SteveMayze/ClockDisplayModule/uctrl/kicad/doc/Salea-FramingError.png

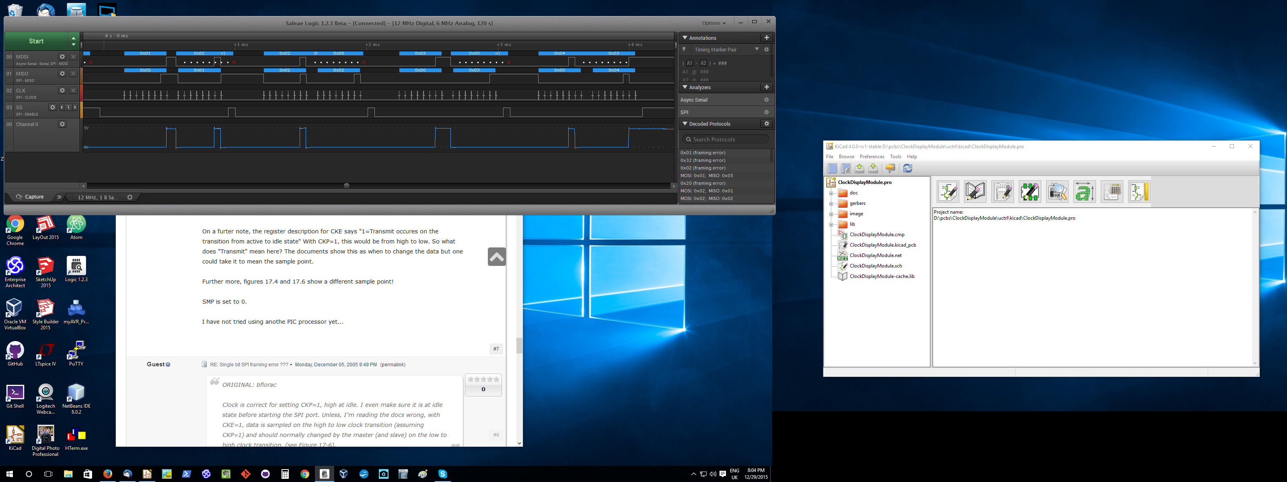
uctrl/kicad/doc/Salea-FramingError.png
