SteveMayze/ClockDisplayModule/README.md

# ClockDisplayModule
A module to provide a 4x7 Segment display digital clock face
