SteveMayze/ClockDisplayModule/uctrl/kicad/doc/my7Segement-Schematic.png

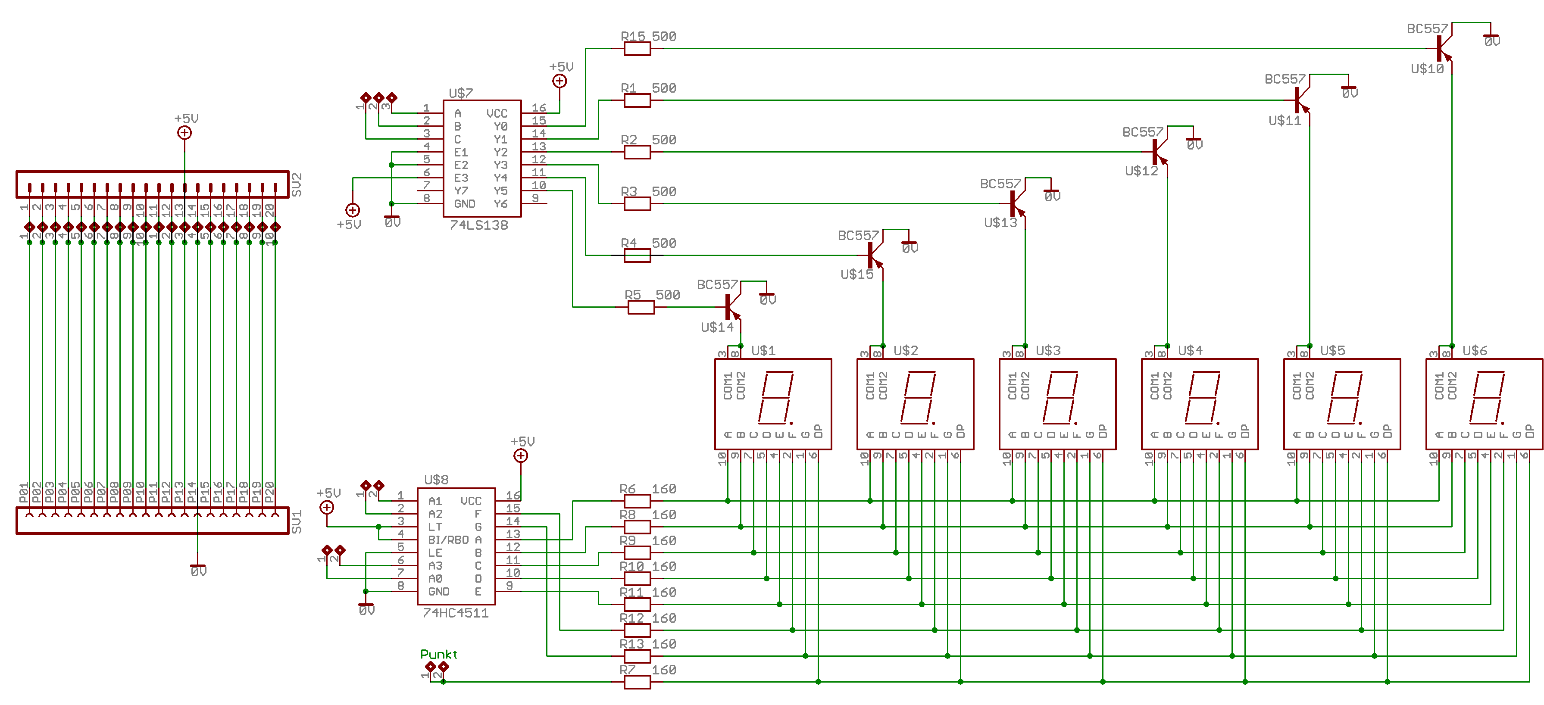
uctrl/kicad/doc/my7Segement-Schematic.png
