SteveMayze/ClockDisplayModule/uctrl/kicad/doc/Salea-FramingError-2.png

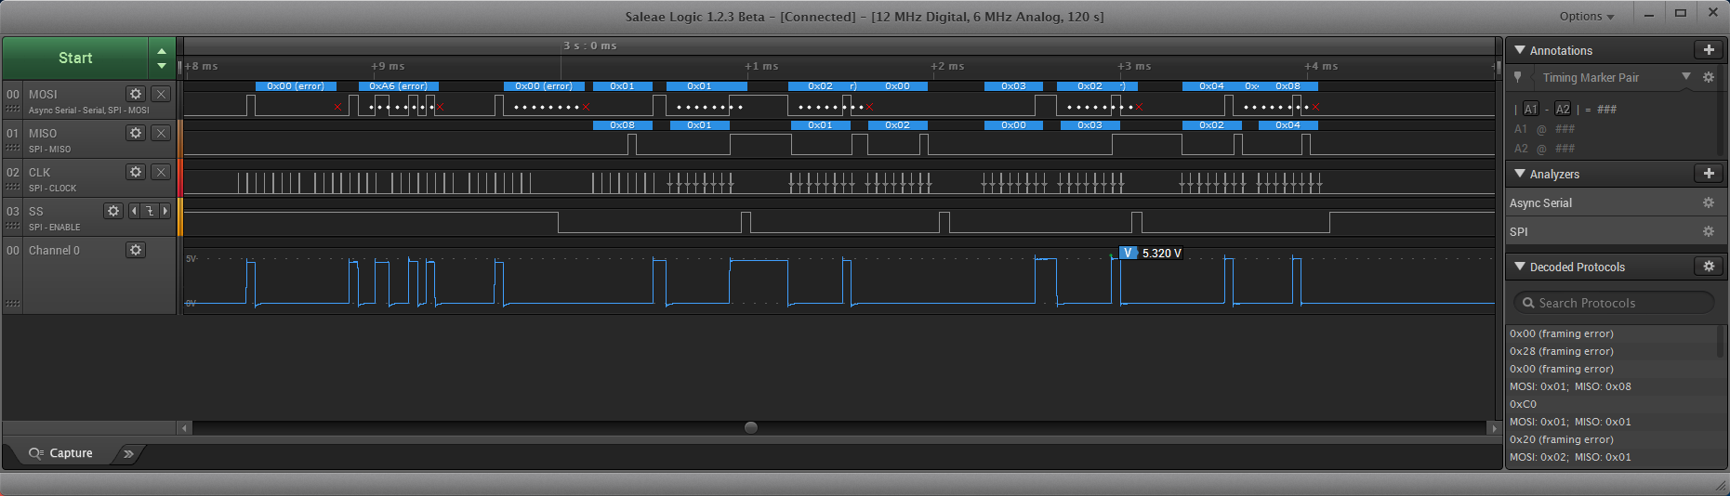
uctrl/kicad/doc/Salea-FramingError-2.png
