SteveMayze/ClockDisplayModule/smallDisplay/kicad/ClockDisplayModule.ods

 |  | Clock Display Module
Reference | Quantity | Value | Footprint | MPN | ConradPN
AFF101 AFF102 AFF103 AFF104 | 4 | NKR161B | ClockFootprints:161_163_Series | NKR161B | N/A
C101 | 1 | 10u | Capacitors_SMD:c_elec_4x5.8 | EEE-FK1C100R | 443516 - 62
C102 | 1 | 0.1u | Capacitors_SMD:C_0805_HandSoldering
D101 | 1 | Colon1 | LEDs:LED-0805 | Value | Value
D102 | 1 | Colon2 | LEDs:LED-0805 | Value | Value
D103 | 1 | Alarm | LEDs:LED-0805 | Value | Value
D104 | 1 | Auto | LEDs:LED-0805 | Value | Value
P101 | 1 | CONN_01X05 | Pin_Headers:Pin_Header_Straight_1x05
R101 | 1 | 25K | Resistors_SMD:R_0805_HandSoldering
R102 R103 R104 R105 | 4 | 0 | Resistors_SMD:R_0805_HandSoldering
U101 | 1 | MAX7221 | ClockFootprints:SOIC-24 | MAX7221 | 170137 - 62
