SteveMayze/ClockDisplayModule/(list of files, cad)

Other CAD files:
smallDisplay/firmware/blinker.obj
smallDisplay/firmware/simpleCheck.obj
