SteveMayze/ClockDisplayModule/smallDisplay/kicad/doc/CurrentUsage.ods

Digit 1 | Digit 2 | Digit 3 | Digit 4 | Colon | Segments | mA | mA/Segment | Rset
2 | 6 | 4 | 7 | 2 | 21 | 34.72 | 1.6533 | 322,580.64516
2 | 6 | 5 | 6 | 2 | 21 | 36.25 | 1.7262 | 308,965.51724
2 | 6 | 5 | 2 | 2 | 17 | 29.95 | 1.7618 | 302,726.76683
2 | 6 | 5 | 5 | 2 | 20 | 34.71 | 1.7355 | 307,308.17248
2 | 6 | 5 | 6 | 2 | 21 | 36.27 | 1.7271 | 308,795.14750
5 | 6 | 6 | 4 | 2 | 23 | 39.70 | 1.7261 | 308,984.04702
5 | 6 | 6 | 5 | 2 | 24 | 41.20 | 1.7167 | 310,679.61165
5 | 6 | 6 | 6 | 2 | 25 | 42.70 | 1.7080 | 312,256.04996
5 | 6 | 2 | 6 | 2 | 21 | 36.40 | 1.7333 | 307,692.30769
5 | 6 | 2 | 5 | 2 | 20 | 34.79 | 1.7395 | 306,601.51384
 |  |  |  |  | 60% Error from the calculated value
