SteveMayze/ClockDisplayModule/uctrl/kicad/ClockDisplayModule.kicad_pcb

## KiCad design uctrl/kicad/ClockDisplayModule.kicad_pcb (2016-01-14)

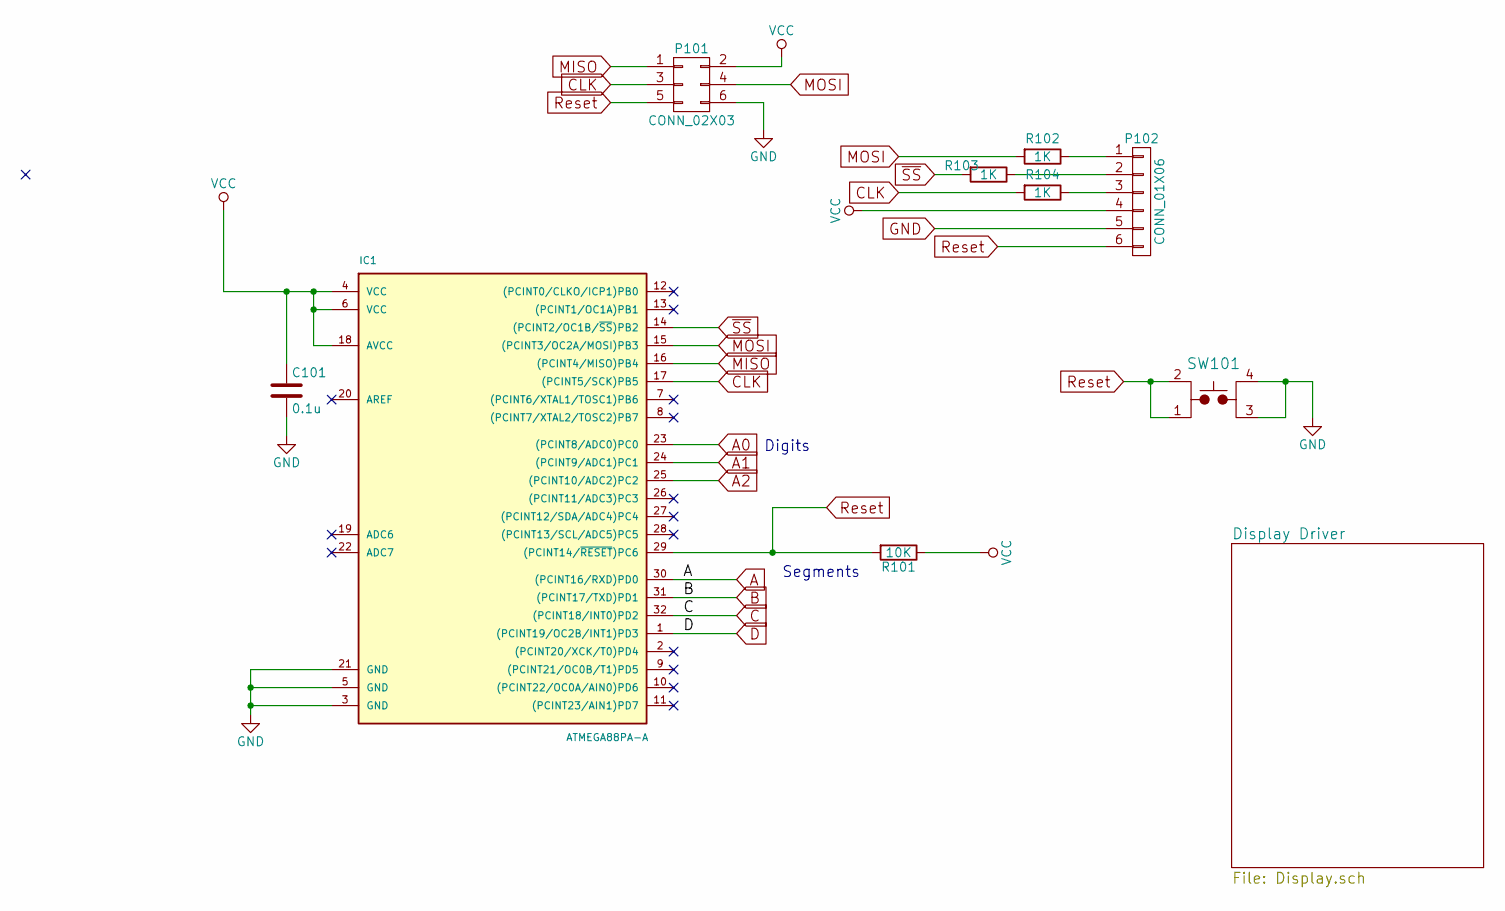
[picture p6: schematic ClockDisplayModule.sch, Clock display module]

Parts:
C101: 0.1u; C_0805
IC1: ATMEGA88PA-A; LQFP-32_7x7mm_Pitch0.8mm
P101: CONN_02X03; Pin_Header_Straight_2x03; MPN WS6G
P102: CONN_01X06; Pin_Header_Straight_1x06
R101: 10K; R_0805
R102, R103, R104: 1K; R_0805
SW101: TL3315NF160Q; PTS525SM15SMTR2LFS

Connections:
A: IC1.30 ((PCINT16/RXD)PD0); also elsewhere on the board
A0: IC1.23 ((PCINT8/ADC0)PC0); also elsewhere on the board
A1: IC1.24 ((PCINT9/ADC1)PC1); also elsewhere on the board
A2: IC1.25 ((PCINT10/ADC2)PC2); also elsewhere on the board
B: IC1.31 ((PCINT17/TXD)PD1); also elsewhere on the board
C: IC1.32 ((PCINT18/INT0)PD2); also elsewhere on the board
CLK: IC1.17 ((PCINT5/SCK)PB5), P101.3, R104.2
D: IC1.1 ((PCINT19/OC2B/INT1)PD3); also elsewhere on the board
GND: C101.2, IC1.3 (GND), IC1.5 (GND), IC1.21 (GND), P101.6, P102.5, SW101.3, SW101.4; also elsewhere on the board
MISO: IC1.16 ((PCINT4/MISO)PB4), P101.1
MOSI: IC1.15 ((PCINT3/OC2A/MOSI)PB3), P101.4, R102.2
unnamed: P102.1, R102.1
unnamed: P102.2, R103.1
unnamed: P102.3, R104.1
Reset: IC1.29 ((PCINT14/~RESET~)PC6), P101.5, P102.6, R101.2, SW101.1, SW101.2
VCC: C101.1, IC1.4 (VCC), IC1.6 (VCC), IC1.18 (AVCC), P101.2, P102.4, R101.1; also elsewhere on the board
~SS: IC1.14 ((PCINT2/OC1B/~SS~)PB2), R103.2

Notes on the sheet:
Digits
Segments

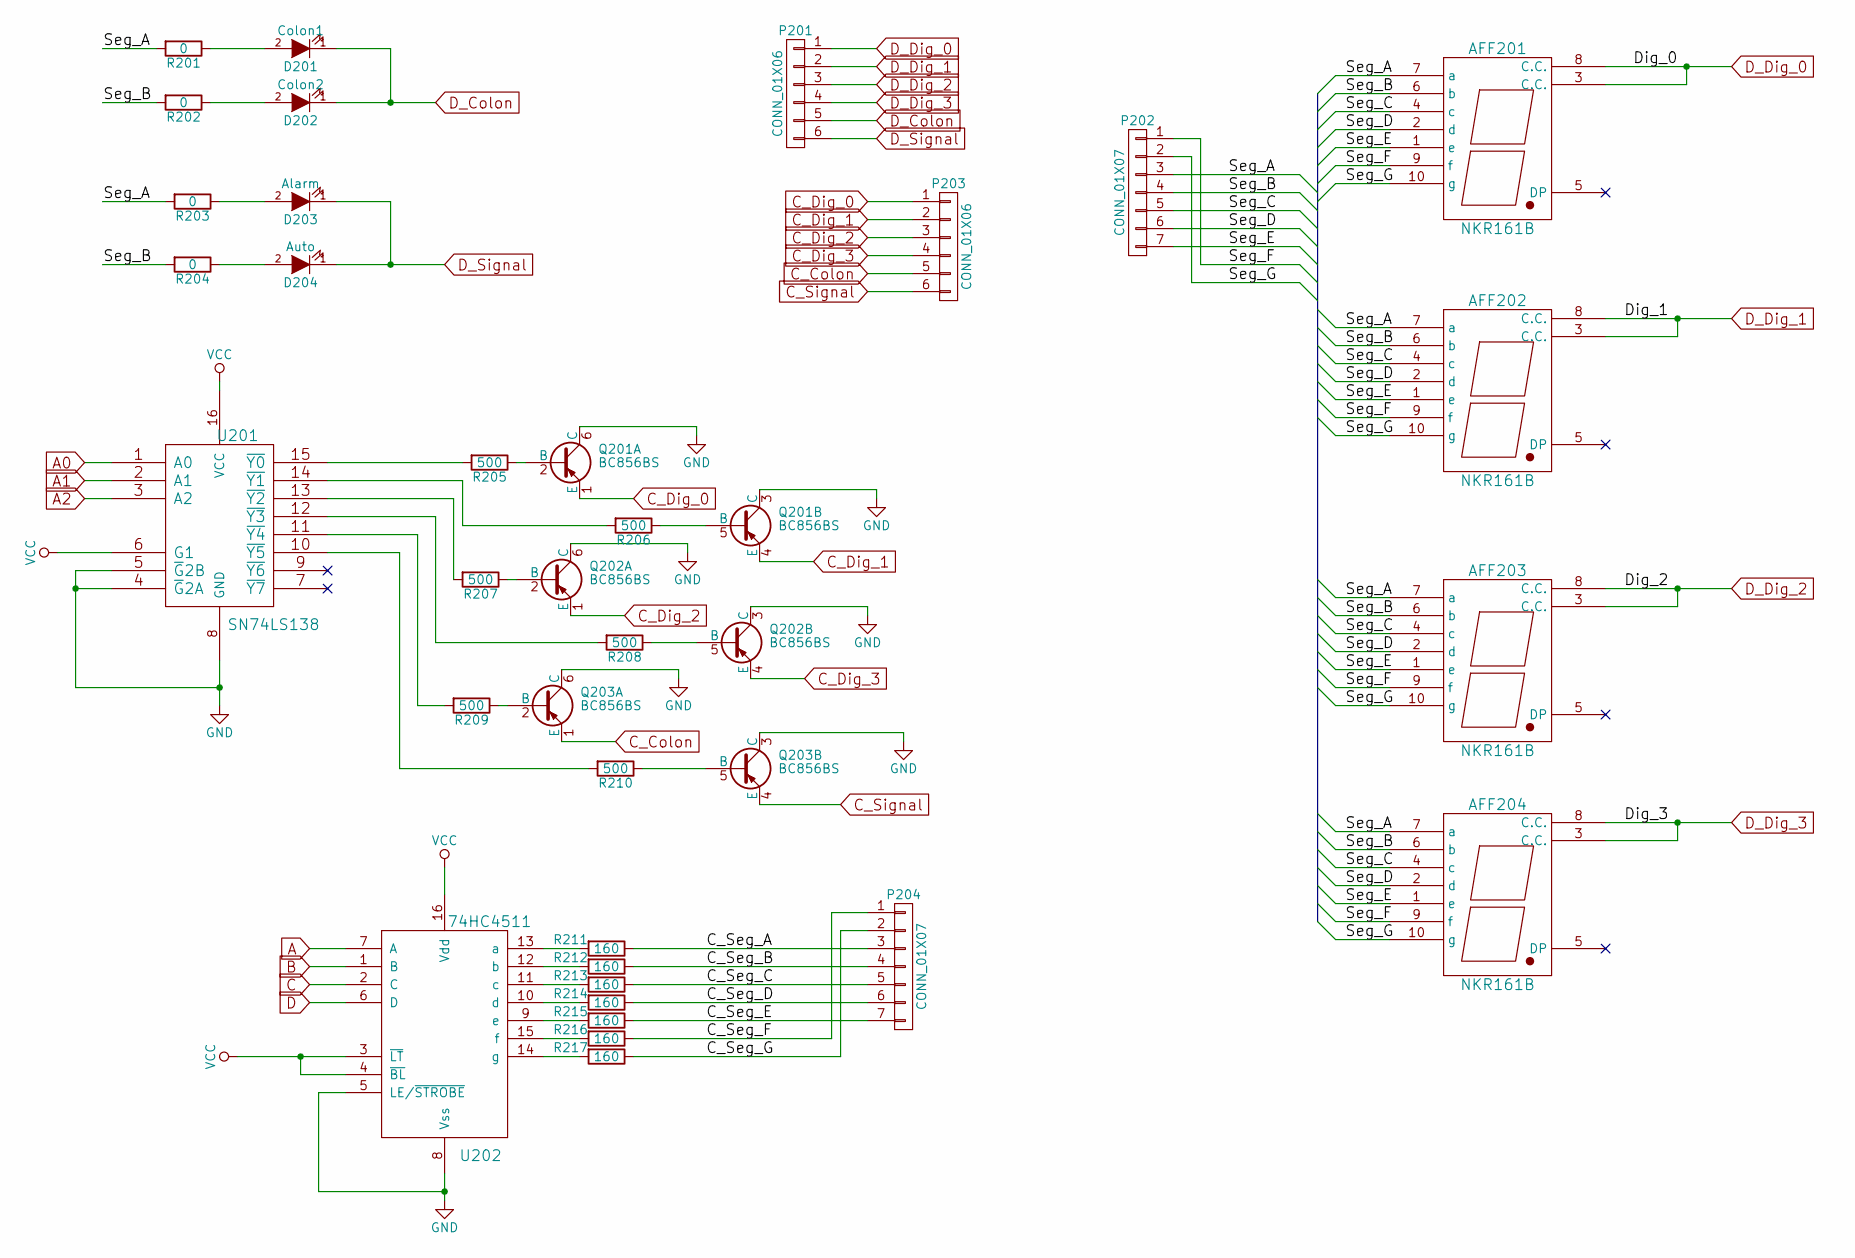
[picture p7: schematic Display.sch]

Parts:
AFF201, AFF202, AFF203, AFF204: NKR161B; 161_163_Series; MPN NKR161B
D201: Colon1; LED-0805; MPN Value
D202: Colon2; LED-0805; MPN Value
D203: Alarm; LED-0805; MPN Value
D204: Auto; LED-0805; MPN Value
P201, P203: CONN_01X06; Pin_Header_Straight_1x06
P202, P204: CONN_01X07; Pin_Header_Straight_1x07
Q201, Q202, Q203: BC856BS; SOT-363; MPN BC856BS
R201, R202, R203, R204: 0; R_0805
R205, R206, R207, R208, R209, R210: 500; R_0805
R211, R212, R213, R214, R215, R216, R217: 160; R_0805
U201: SN74LS138; SOIC-16; MPN SN74LS138NSR
U202: 74HC4511; SOIC-16; MPN CD4511BNSR

Connections:
/Display Driver/C_Seg_A: P204.3, R211.1
/Display Driver/C_Seg_B: P204.4, R212.1
/Display Driver/C_Seg_C: P204.5, R213.1
/Display Driver/C_Seg_D: P204.6, R214.1
/Display Driver/C_Seg_E: P204.7, R215.1
/Display Driver/C_Seg_F: P204.1, R216.1
/Display Driver/C_Seg_G: P204.2, R217.1
/Display Driver/Seg_A: AFF201.7 (a), AFF202.7 (a), AFF203.7 (a), AFF204.7 (a), P202.3, R201.2, R203.2
/Display Driver/Seg_B: AFF201.6 (b), AFF202.6 (b), AFF203.6 (b), AFF204.6 (b), P202.4, R202.2, R204.2
/Display Driver/Seg_C: AFF201.4 (c), AFF202.4 (c), AFF203.4 (c), AFF204.4 (c), P202.5
/Display Driver/Seg_D: AFF201.2 (d), AFF202.2 (d), AFF203.2 (d), AFF204.2 (d), P202.6
/Display Driver/Seg_E: AFF201.1 (e), AFF202.1 (e), AFF203.1 (e), AFF204.1 (e), P202.7
/Display Driver/Seg_F: AFF201.9 (f), AFF202.9 (f), AFF203.9 (f), AFF204.9 (f), P202.1
/Display Driver/Seg_G: AFF201.10 (g), AFF202.10 (g), AFF203.10 (g), AFF204.10 (g), P202.2
A: U202.7 (A); also elsewhere on the board
A0: U201.1 (A0); also elsewhere on the board
A1: U201.2 (A1); also elsewhere on the board
A2: U201.3 (A2); also elsewhere on the board
B: U202.1 (B); also elsewhere on the board
C: U202.2 (C); also elsewhere on the board
C_Colon: P203.5, Q203.1 (E)
C_Dig_0: P203.1, Q201.1 (E)
C_Dig_1: P203.2, Q201.4 (E)
C_Dig_2: P203.3, Q202.1 (E)
C_Dig_3: P203.4, Q202.4 (E)
C_Signal: P203.6, Q203.4 (E)
D: U202.6 (D); also elsewhere on the board
D_Colon: D201.1 (K), D202.1 (K), P201.5
D_Dig_0: AFF201.3 (C.C.), AFF201.8 (C.C.), P201.1
D_Dig_1: AFF202.3 (C.C.), AFF202.8 (C.C.), P201.2
D_Dig_2: AFF203.3 (C.C.), AFF203.8 (C.C.), P201.3
D_Dig_3: AFF204.3 (C.C.), AFF204.8 (C.C.), P201.4
D_Signal: D203.1 (K), D204.1 (K), P201.6
GND: Q201.3 (C), Q201.6 (C), Q202.3 (C), Q202.6 (C), Q203.3 (C), Q203.6 (C), U201.4 (~G~2A), U201.5 (~G~2B), U201.8 (GND), U202.5 (LE/~STROBE), U202.8 (Vss); also elsewhere on the board
unnamed: D201.2 (A), R201.1
unnamed: D202.2 (A), R202.1
unnamed: D203.2 (A), R203.1
unnamed: D204.2 (A), R204.1
unnamed: Q201.2 (B), R205.1
unnamed: Q201.5 (B), R206.1
unnamed: Q202.2 (B), R207.1
unnamed: Q202.5 (B), R208.1
unnamed: Q203.2 (B), R209.1
unnamed: Q203.5 (B), R210.1
unnamed: R205.2, U201.15 (~Y0)
unnamed: R206.2, U201.14 (~Y1)
unnamed: R207.2, U201.13 (~Y2)
unnamed: R208.2, U201.12 (~Y3)
unnamed: R209.2, U201.11 (~Y4)
unnamed: R210.2, U201.10 (~Y5)
unnamed: R211.2, U202.13 (a)
unnamed: R212.2, U202.12 (b)
unnamed: R213.2, U202.11 (c)
unnamed: R214.2, U202.10 (d)
unnamed: R215.2, U202.9 (e)
unnamed: R216.2, U202.15 (f)
unnamed: R217.2, U202.14 (g)
VCC: U201.6 (G1), U201.16 (VCC), U202.3 (~LT), U202.4 (~BL), U202.16 (Vdd); also elsewhere on the board

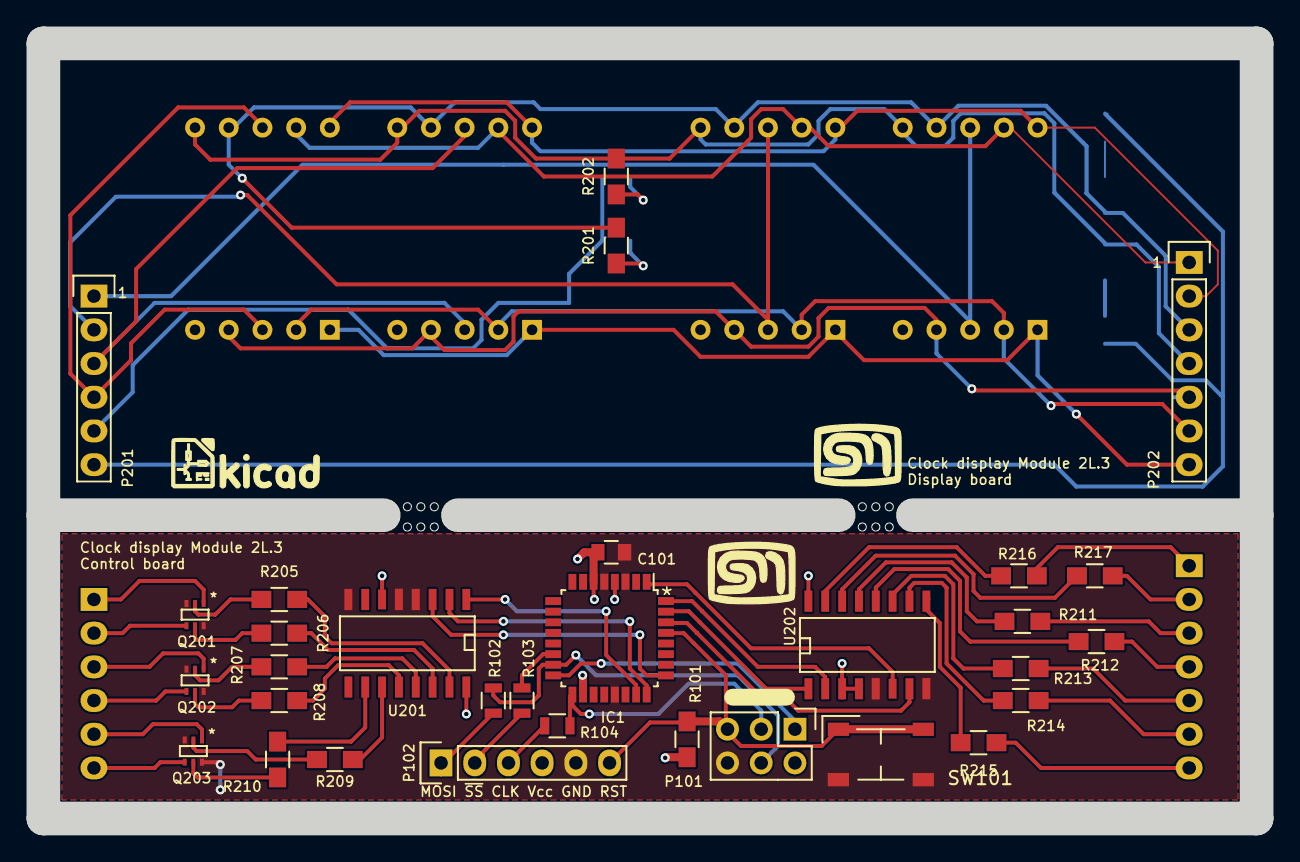
[picture p8: board uctrl/kicad/ClockDisplayModule.kicad_pcb from above]

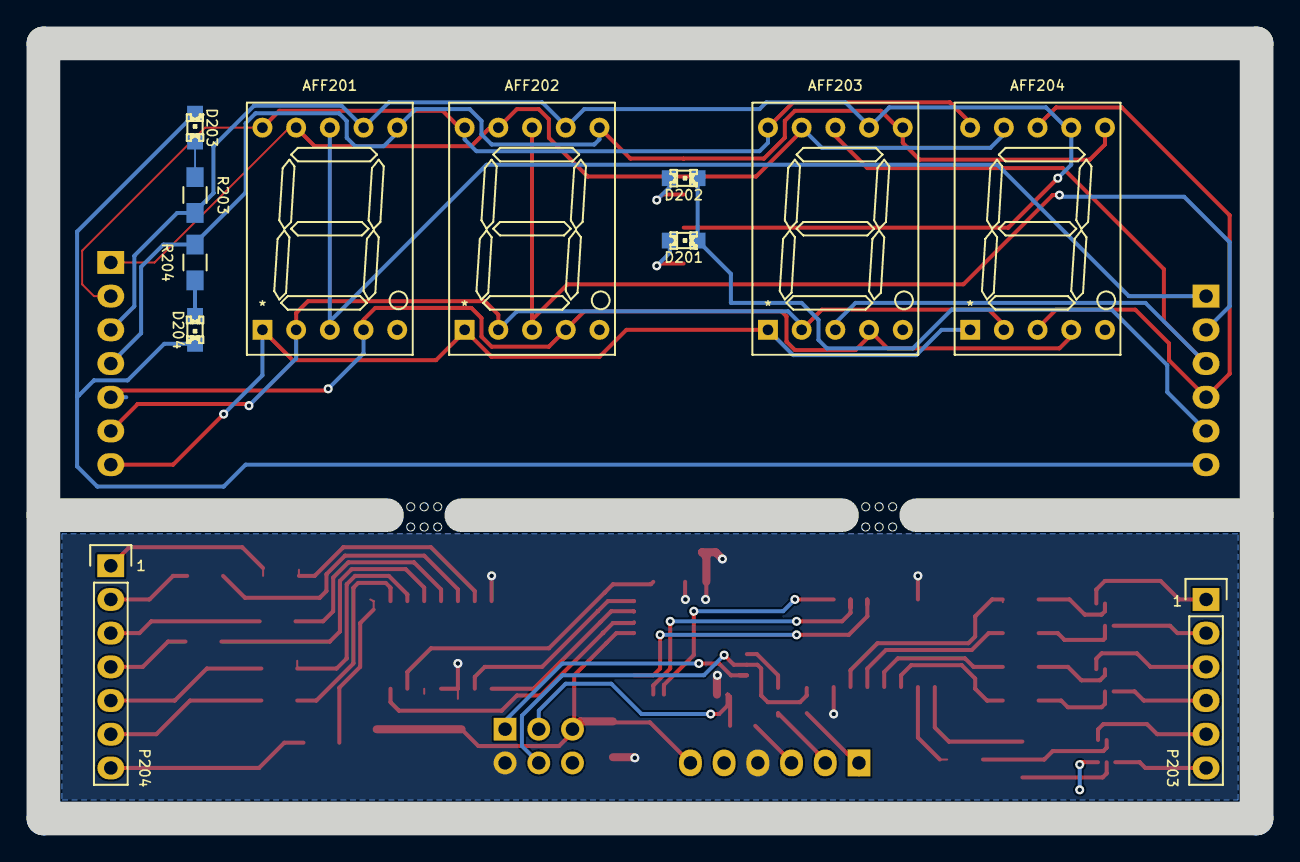
[picture p9: board uctrl/kicad/ClockDisplayModule.kicad_pcb from below]

Board: 2 copper layers, 91.4 x 58.4 mm, 43 parts (12 on the bottom side), 66 nets.
