SteveMayze/ClockDisplayModule/largeDisplay/kicad/ClockDisplayModule.kicad_pcb

## KiCad design largeDisplay/kicad/ClockDisplayModule.kicad_pcb (2015-12-12)

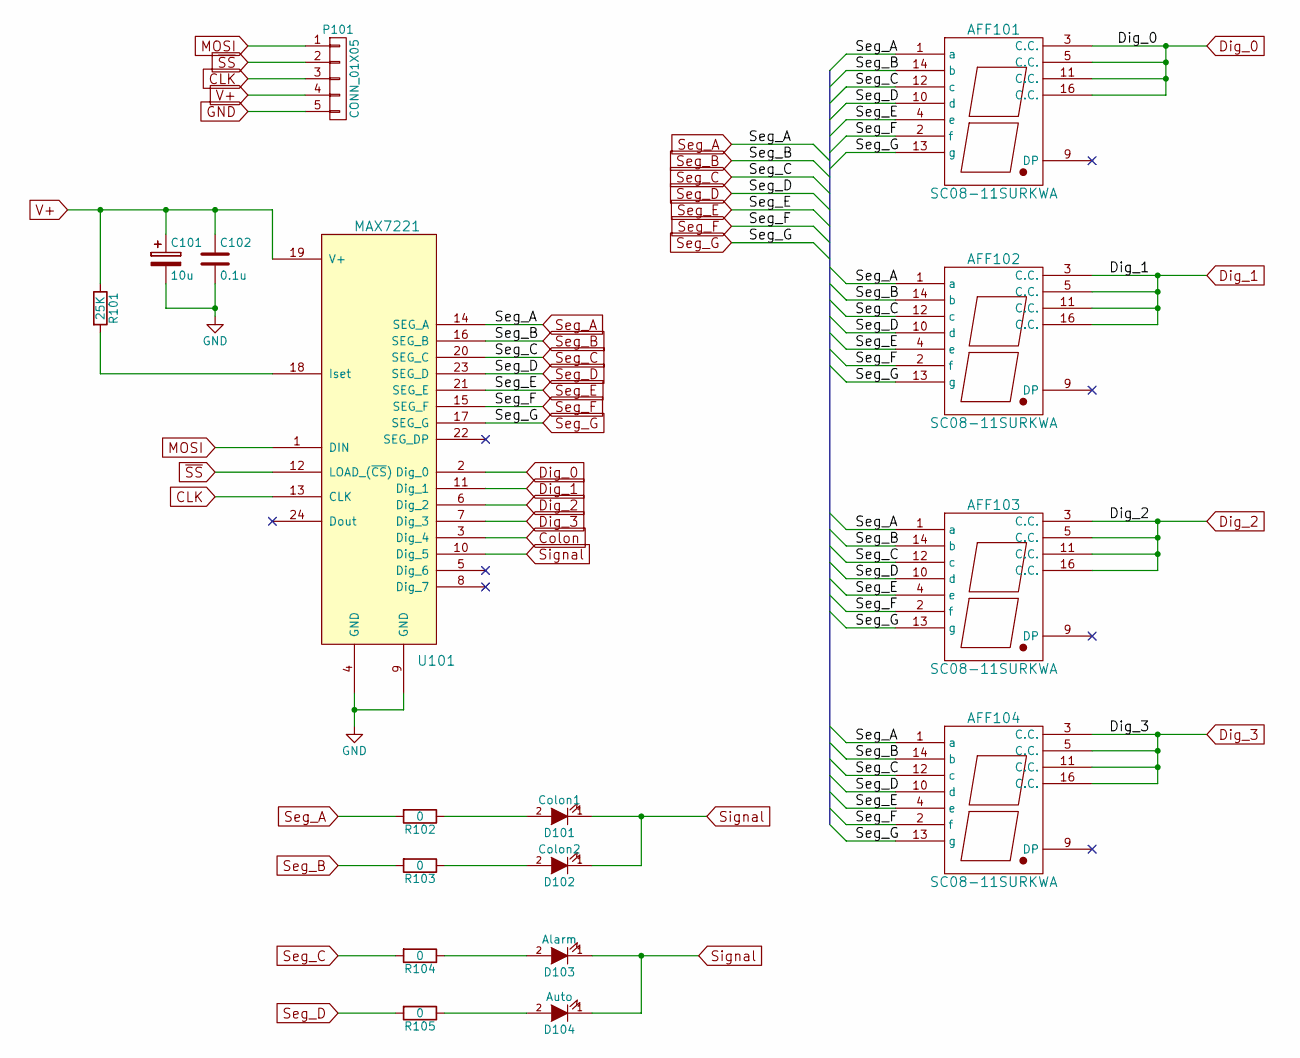
[picture p10: schematic ClockDisplayModule.sch]

Parts:
AFF101, AFF102, AFF103, AFF104: SC08-11SURKWA
C101: 10u; c_elec_4x5.8; MPN EEE-FK1C100R
C102: 0.1u; C_0805_HandSoldering
D101: Colon1; LED-0805; MPN Value
D102: Colon2; LED-0805; MPN Value
D103: Alarm; LED-0805; MPN Value
D104: Auto; LED-0805; MPN Value
P101: CONN_01X05; Pin_Header_Straight_1x05
R101: 25K; R_0805_HandSoldering
R102, R103, R104, R105: 0; R_0805_HandSoldering
U101: MAX7221; SOIC-24; MPN MAX7221

Connections:
CLK: P101.3, U101.13 (CLK)
Dig_0: AFF101.3 (C.C.), AFF101.5 (C.C.), AFF101.11 (C.C.), AFF101.16 (C.C.), U101.2 (Dig_0)
Dig_1: AFF102.3 (C.C.), AFF102.5 (C.C.), AFF102.11 (C.C.), AFF102.16 (C.C.), U101.11 (Dig_1)
Dig_2: AFF103.3 (C.C.), AFF103.5 (C.C.), AFF103.11 (C.C.), AFF103.16 (C.C.), U101.6 (Dig_2)
Dig_3: AFF104.3 (C.C.), AFF104.5 (C.C.), AFF104.11 (C.C.), AFF104.16 (C.C.), U101.7 (Dig_3)
GND: C101.2, C102.2, P101.5, U101.4 (GND), U101.9 (GND)
MOSI: P101.1, U101.1 (DIN)
unnamed: D101.2 (A), R102.1
unnamed: D102.2 (A), R103.1
unnamed: D103.2 (A), R104.1
unnamed: D104.2 (A), R105.1
unnamed: R101.2, U101.18 (Iset)
Seg_A: AFF101.1 (a), AFF102.1 (a), AFF103.1 (a), AFF104.1 (a), R102.2, U101.14 (SEG_A)
Seg_B: AFF101.14 (b), AFF102.14 (b), AFF103.14 (b), AFF104.14 (b), R103.2, U101.16 (SEG_B)
Seg_C: AFF101.12 (c), AFF102.12 (c), AFF103.12 (c), AFF104.12 (c), R104.2, U101.20 (SEG_C)
Seg_D: AFF101.10 (d), AFF102.10 (d), AFF103.10 (d), AFF104.10 (d), R105.2, U101.23 (SEG_D)
Seg_E: AFF101.4 (e), AFF102.4 (e), AFF103.4 (e), AFF104.4 (e), U101.21 (SEG_E)
Seg_F: AFF101.2 (f), AFF102.2 (f), AFF103.2 (f), AFF104.2 (f), U101.15 (SEG_F)
Seg_G: AFF101.13 (g), AFF102.13 (g), AFF103.13 (g), AFF104.13 (g), U101.17 (SEG_G)
Signal: D101.1 (K), D102.1 (K), D103.1 (K), D104.1 (K), U101.10 (Dig_5)
V+: C101.1, C102.1, P101.4, R101.1, U101.19 (V+)
~SS: P101.2, U101.12 (LOAD_(~CS))

Board: 2 copper layers, 17 parts (12 on the bottom side), 22 nets, no tracks yet.
