SteveMayze/ClockDisplayModule/uctrl/firmware/powerTewst.bas

$regfile = "m88pdef.dat"
$crystal = 1000000
$hwstack = 40
$swstack = 16
$framesize = 32

' $baud = 4800


Config Portc = Output                                       ' Digits
Config Portd = Output                                       ' Segments

Dim Digit As Byte
Dim Count As Byte

Portd = Makebcd(8)

Do

   For Digit = 0 To 5
     ' For Count = 0 To 5
         Portc = Digit
         Portd = Makebcd(8)
         Waitms 1
     ' Next                                                  ' count
   Next                                                     ' digit

Loop

End
