SteveMayze/ClockDisplayModule/uctrl/firmware/blinker.bas

$Regfile="m88pdef.dat"
$Crystal=4000000
$hwstack=40
$swstack=40
$framesize=60



' $baud = 4800


Config Portb = Output


Portb.0 = 1

Do

   Set Portb.0

   Waitms 1000

   Reset Portb.0

   ' Waitms 500

   Set Portb.1

   Waitms 1000

   Reset Portb.1

   Waitms 2000

Loop

End
