SteveMayze/ClockDisplayModule/(commit log)

2015-06-07 Initial schematic
    [ClockDisplayModule.sch]
2015-06-08 Library correction and rework of schematic
    [ClockDisplayModule.sch]
2015-06-08 Initial layout
    [ClockDisplayModule.kicad_pcb, ClockDisplayModule.sch]
2015-06-09 Small changes to schematic
    [ClockDisplayModule.kicad_pcb, ClockDisplayModule.sch]
2015-06-09 Initial layout before routing
    [ClockDisplayModule.kicad_pcb, ClockDisplayModule.sch]
2015-06-10 Layout complete and board ordered
    [ClockDisplayModule-B_Cu.gbl, ClockDisplayModule-B_Mask.gbs, ClockDisplayModule-B_SilkS.gbo, ClockDisplayModule-Edge_Cuts.gbr, ClockDisplayModule-F_Cu.gtl, ClockDisplayModule-F_Mask.gts, ClockDisplayModule-F_SilkS.gto, ClockDisplayModule.drl]
2015-06-16 Initial trail of the layout. The given board is not big enough
    [ClockDisplayModule.kicad_pcb, ClockDisplayModule.sch]
2015-06-16 Initial schematic for the controller based display driver
    [ClockDisplayModule.sch]
2015-06-21 Correction to the Conrad part numbers
    Correction to the Conrad part numbers for the 7 Segment displays
    [ClockDisplayModule.sch]
2015-06-23 Preperation for layout
    [ClockDisplayModule.sch, Display.sch]
2015-06-24 Started layout
    [ClockDisplayModule.kicad_pcb, ClockDisplayModule.sch, Display.sch]
2015-06-25 Updated the layout for the controller side
    [ClockDisplayModule.kicad_pcb, ClockDisplayModule.sch, Display.sch]
2015-06-27 Board layout completed
    [ClockDisplayModule-B_Cu.gbl, ClockDisplayModule-B_Mask.gbs, ClockDisplayModule-B_Paste.gbp, ClockDisplayModule-B_SilkS.gbo, ClockDisplayModule-Edge_Cuts.gbr, ClockDisplayModule-F_Cu.gtl, ClockDisplayModule-F_Paste.gtp, ClockDisplayModule-F_SilkS.gto]
2015-06-27 Added annotiations and logo
    [ClockDisplayModule-B_Cu.gbl, ClockDisplayModule-B_Mask.gbs, ClockDisplayModule-B_Paste.gbp, ClockDisplayModule-B_SilkS.gbo, ClockDisplayModule-Edge_Cuts.gbr, ClockDisplayModule-F_Cu.gtl, ClockDisplayModule-F_Mask.gts, ClockDisplayModule-F_Paste.gtp]
2015-06-27 refined the logo image
    [ClockDisplayModule.kicad_pcb]
2015-06-27 Added breakout for the board
    [ClockDisplayModule.kicad_pcb]
2015-06-28 Updated the logo
    [ClockDisplayModule.kicad_pcb]
2015-07-01 More refinements and updates to logos
    [ClockDisplayModule-B_Cu.gbl, ClockDisplayModule-B_Mask.gbs, ClockDisplayModule-B_Paste.gbp, ClockDisplayModule-B_SilkS.gbo, ClockDisplayModule-Edge_Cuts.gbr, ClockDisplayModule-Edge_Cuts.gko, ClockDisplayModule-F_Cu.gtl, ClockDisplayModule-F_Mask.gts]
2015-07-01 Final logo added
    [ClockDisplayModule-B_Cu.gbl, ClockDisplayModule-B_Mask.gbs, ClockDisplayModule-B_Paste.gbp, ClockDisplayModule-B_SilkS.gbo, ClockDisplayModule-Edge_Cuts.gko, ClockDisplayModule-F_Cu.gtl, ClockDisplayModule-F_Mask.gts, ClockDisplayModule-F_Paste.gtp]
2015-07-04 Changes to the gerbers
    [ClockDisplayModule-B_Cu.gbl, ClockDisplayModule-B_Mask.gbs, ClockDisplayModule-B_Paste.gbp, ClockDisplayModule-B_SilkS.gbo, ClockDisplayModule-Edge_Cuts.gko, ClockDisplayModule-F_Cu.gtl, ClockDisplayModule-F_Mask.gts, ClockDisplayModule-F_Paste.gtp]
2015-07-04 Added a BOM
    [ClockDisplayModule.csv, ClockDisplayModule.ods]
2015-07-04 Added some Conrad part numbers
    [ClockDisplayModule.sch]
2015-07-07 Added initial firmware code
    [SIMPLECHECK.CFG, simpleCheck.obj]
2015-07-08 Initial test firmware created
    The blinker is just a simple program to verify the ISP. The simpleCheck
    can communicate to the clock module and the display module.
    [BLINKER.CFG, blinker.obj, simpleCheck.obj]
2015-07-15 Added the firmware for the MAX7221 display module
    [BLINKER.CFG, SIMPLECHECK.CFG, blinker.obj, simpleCheck.obj]
2015-07-15 Added BOM
    [ClockDisplayModule.csv, ClockDisplayModule.ods]
2015-07-21 small correction
    [Display.sch]
2015-07-21 Added some current usage results for the display
    [CurrentUsage.ods]
2015-07-23 Simple Blinker for the breadboard test
    [BLINKER.CFG, blinker.obj]
2015-07-24 Added first check blinker for the uControl display module
    [FIRSTCHECK-BLINKTEST.CFG, FirstCheck-BlinkTest.obj]
2015-07-24 Correction to microcontroller footprint
    [ClockDisplayModule-B_Cu.gbl, ClockDisplayModule-B_Mask.gbs, ClockDisplayModule-B_Paste.gbp, ClockDisplayModule-B_SilkS.gbo, ClockDisplayModule-Edge_Cuts.gm1, ClockDisplayModule-F_Cu.gtl, ClockDisplayModule-F_Mask.gts, ClockDisplayModule-F_Paste.gtp]
2015-07-24 Created the kicad-rev_2 directory to provide the corrected board without the LED section
    [ClockDisplayModule-B_Cu.gbl, ClockDisplayModule-B_Mask.gbs, ClockDisplayModule-B_Paste.gbp, ClockDisplayModule-B_SilkS.gbo, ClockDisplayModule-Edge_Cuts.gko, ClockDisplayModule-F_Cu.gtl, ClockDisplayModule-F_Mask.gts, ClockDisplayModule-F_Paste.gtp]
2015-08-22 Corrections to the layout based on testing
    [ClockDisplayModule.csv, ClockDisplayModule.kicad_pcb, ClockDisplayModule.sch]
2015-08-23 Added some firmware for the intial testing
    [BLINKER.CFG, FirstCheck-BlinkTest.obj, blinker.obj]
2015-08-29 checkin before moving to Vagrant
    [Display.sch]
2015-09-08 Update to the driver code to a working model
2015-09-20 Updated they layout
    [ClockDisplayModule.sch, Display.sch]
2015-12-03 Updated display driver to support power mode, colons and indicators better
2015-12-03 Updated main project with fixes from issues discovered when brining up the board
    [ClockDisplayModule.kicad_pcb, ClockDisplayModule.sch, Display.sch]
2015-12-03 Updated the footprint for the reset switch
    [ClockDisplayModule.kicad_pcb]
2015-12-08 Created Gerbers and orderd 2l.3 (REV3) of the board
    [ClockDisplayModule-B_Cu.gbl, ClockDisplayModule-B_Mask.gbs, ClockDisplayModule-B_Paste.gbp, ClockDisplayModule-B_SilkS.gbo, ClockDisplayModule-Edge_Cuts.gko, ClockDisplayModule-Edge_Cuts.gm1, ClockDisplayModule-F_Cu.gtl, ClockDisplayModule-F_Mask.gts]
2015-12-10 Enhancements to the micro controlled display firmware
    [COUNTUP2TEST.CFG, COUNTUP4TEST.CFG, DISPLAYDRIVER.CFG, MAINBOARDCONTROLLER.CFG]
2015-12-12 Removed the kicad cache from the .gitignore
2015-12-12 moved the smallDisplay branch to its own directory
    [BLINKER.CFG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]
2015-12-12 Moved the largeDisplay to its own directory
    [ClockDisplayModule.kicad_pcb, ClockDisplayModule.sch]
2015-12-12 Moved the UCtrl_small branch to the ucrl directory
    [BLINKER.CFG, COUNTUP2TEST.CFG, COUNTUP4TEST.CFG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]
2015-12-12 Revert "moved the smallDisplay branch to its own directory"
    This reverts commit b078eeab5859ec3d63b3dc095890a6a090f9175d.
    [BLINKER.CFG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]
2015-12-12 Revert "Moved the largeDisplay to its own directory"
    This reverts commit fb9d403b8ae12a440a5377ca2228b0d60af6e2e4.
    [ClockDisplayModule.kicad_pcb, ClockDisplayModule.sch]
2015-12-12 Revert "Moved the UCtrl_small branch to the ucrl directory"
    This reverts commit 840599a76f67236bf795ed3e24a3de87f15bbceb.
    [BLINKER.CFG, COUNTUP2TEST.CFG, COUNTUP4TEST.CFG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]
2015-12-12 Copied the smallDisplay branch to its own directory
    [BLINKER.CFG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]
2015-12-12 Copied the largeDisplay label to its own directory
    [ClockDisplayModule.kicad_pcb, ClockDisplayModule.sch]
2015-12-12 Copied the UCtrl_small to the uctrl directory
    [BLINKER.CFG, COUNTUP2TEST.CFG, COUNTUP4TEST.CFG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]
2015-12-12 Copied UCtrl_small branch to the uctl directory
    [FirstCheck-BlinkTest.obj, blinker.obj, simpleCheck.obj]
2015-12-12 Revert "Copied UCtrl_small branch to the uctl directory"
    This reverts commit c9353255f9380f72b0e1684e404d0a0f8c6bfb7f.
    [FirstCheck-BlinkTest.obj, blinker.obj, simpleCheck.obj]
2015-12-12 Final clean up of merging the branches to their own directories
    [BLINKER.CFG, COUNTUP2TEST.CFG, COUNTUP4TEST.CFG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]
2015-12-12 Updated the reset switch symbol and footprint
    [ClockDisplayModule.kicad_pcb, ClockDisplayModule.sch]
2015-12-13 Small update to the config spi
2015-12-13 Tweaking the SPI config
2015-12-31 An intermediate save of code that is basically working
    [ClockDisplayModule.sch, DISPLAYDRIVER.CFG, Display.sch]
2016-01-04 Cleaned up the timer specifications for the 10th second timer
2016-01-14 Correction to segments F and G!
    [ClockDisplayModule.kicad_pcb, Display.sch]
2016-01-24 Updated the 'blink' timer to 2Hz rather than 10Hz
